Ztubben/autopilot_main_pcb/autopilot_main_board.kicad_pcb

## KiCad design autopilot_main_board.kicad_pcb (2026-03-28)

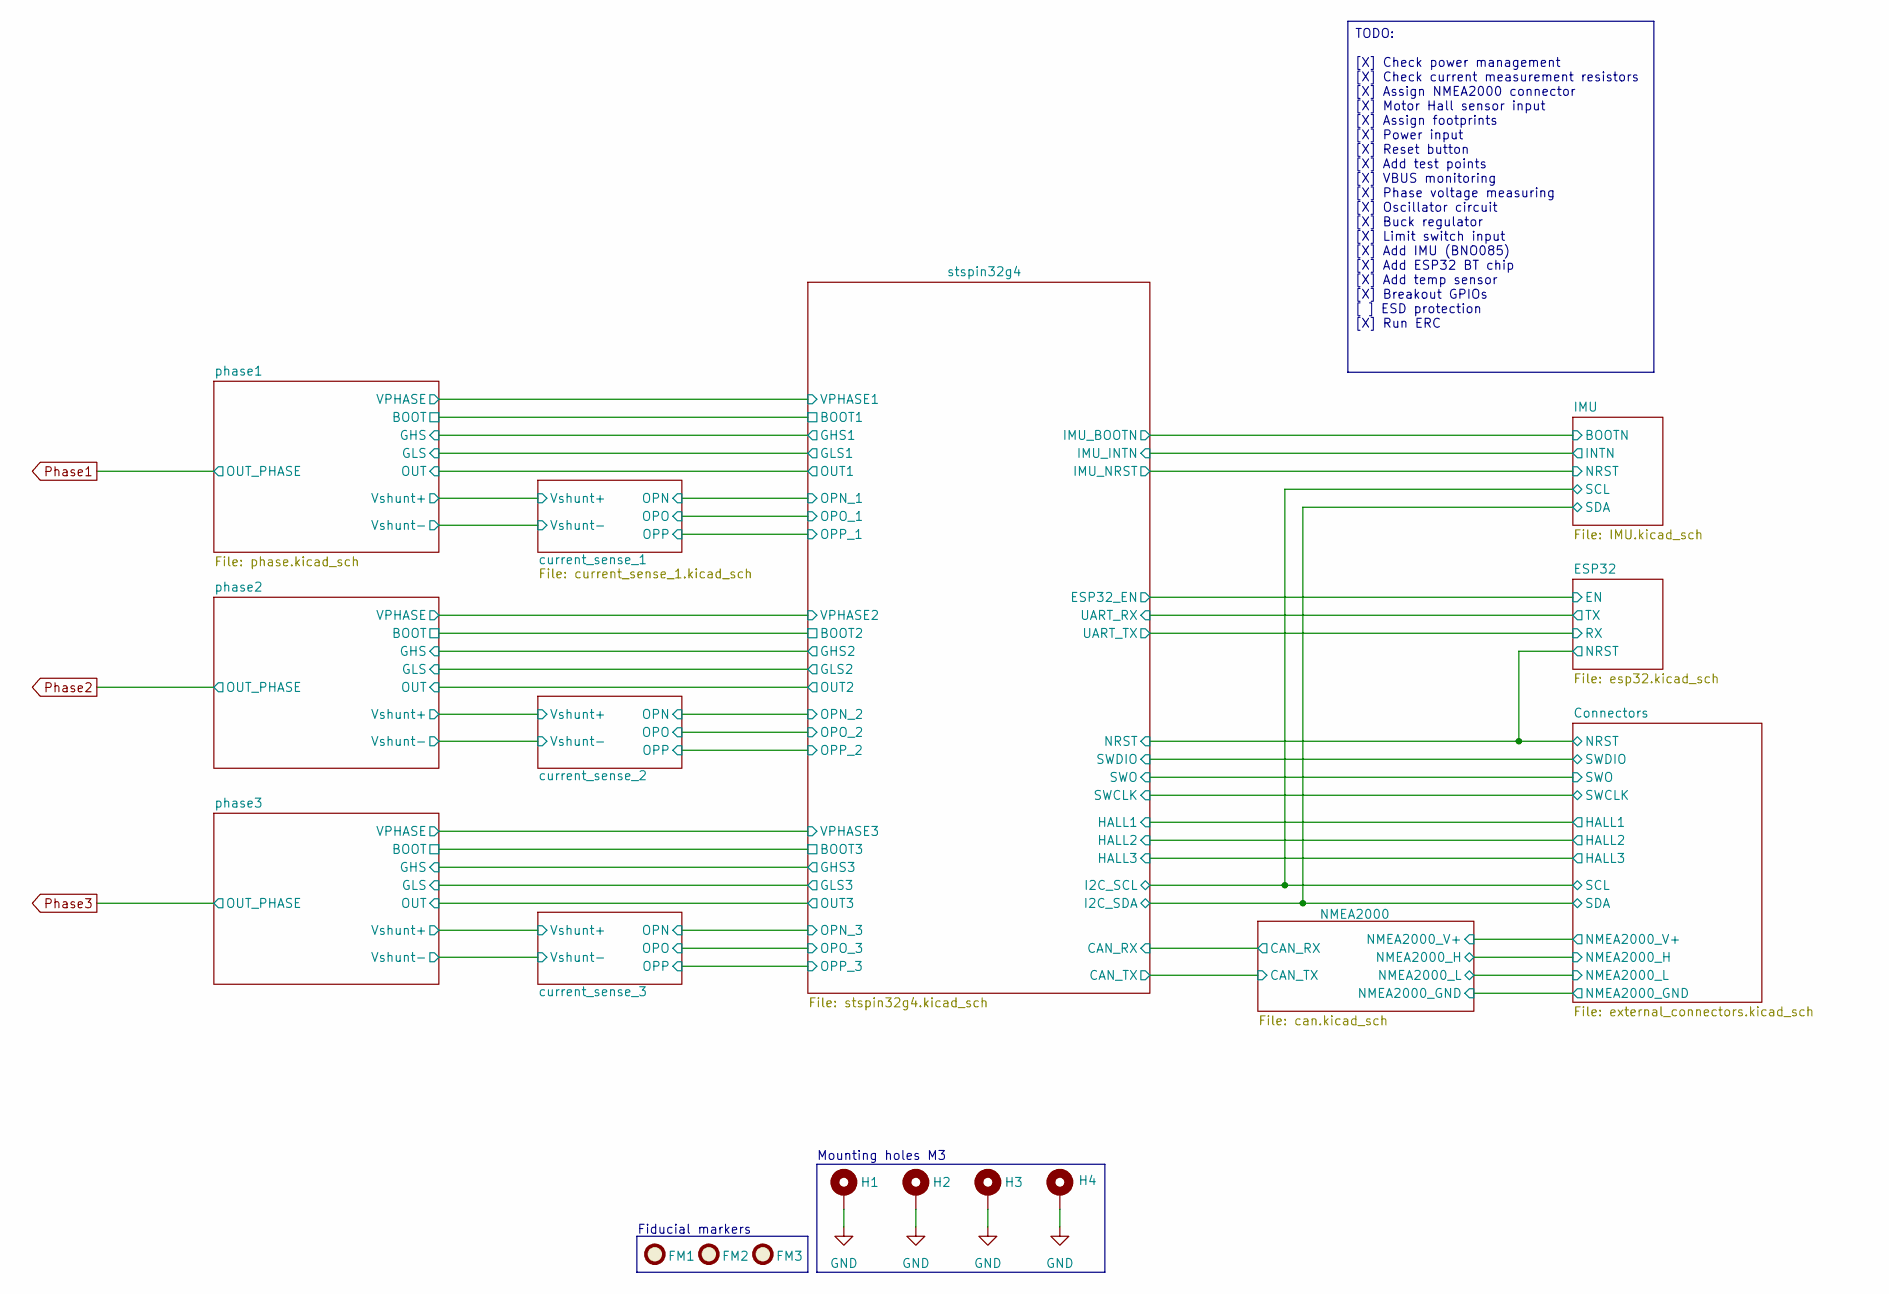
[picture p1: schematic autopilot_main_board.kicad_sch, Autopilot mainboard stspin32g4]

Parts:
FM1, FM2, FM3: Fiducial_1mm_Mask2mm
H1, H2, H3, H4: MountingHole_3.2mm_M3_DIN965_Pad

Connections:
GND: H1.1, H2.1, H3.1, H4.1; also elsewhere on the board

Notes on the sheet:
Mounting holes M3
Fiducial markers
TODO: [X] Check power management [X] Check current measurement resistors [X] Assign NMEA2000 connector [X] Motor Hall sensor input [X] Assign footprints [X] Power input [X] Reset button [X] Add test points [X] VBUS monitoring [X] Phase voltage measuring [X] Oscillator circuit [X] Buck regulator [X]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

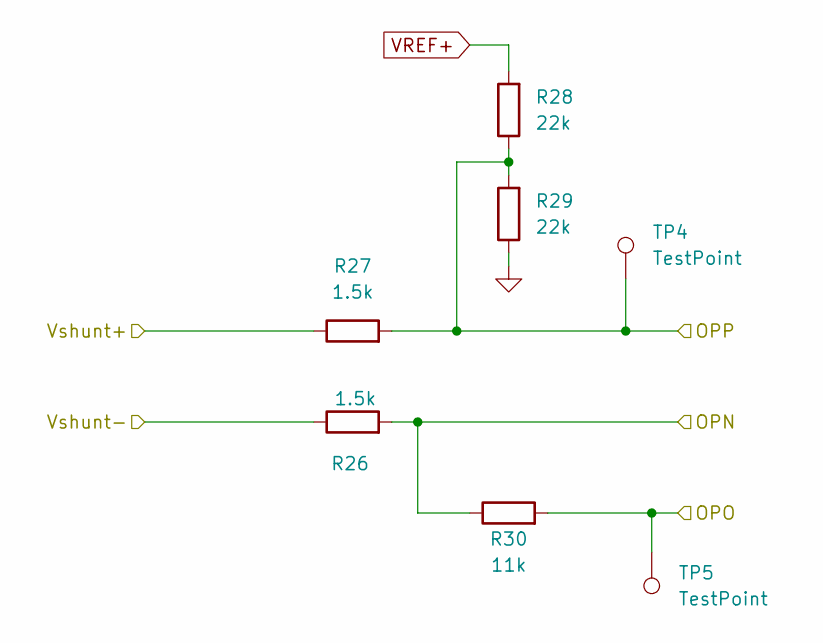
[picture p2: schematic current_sense_1.kicad_sch]

Parts:
R26, R27: 1.5k; R_0603_1608Metric
R28, R29: 22k; R_0603_1608Metric
R30: 11k; R_0603_1608Metric
TP4, TP5: TestPoint; TestPoint_Pad_D2.0mm

Connections:
/current_sense_1/OPN: R26.2, R30.1; also elsewhere on the board
/current_sense_1/OPO: R30.2, TP5.1; also elsewhere on the board
/current_sense_1/OPP: R27.2, R28.1, R29.2, TP4.1; also elsewhere on the board
/current_sense_1/Vshunt+: R27.1; also elsewhere on the board
GND: R26.1, R29.1; also elsewhere on the board
VREF+: R28.2; also elsewhere on the board

Parts of its further copies:
R31, R32, R44, R45: 1.5k; R_0603_1608Metric
R33, R34, R46, R47: 22k; R_0603_1608Metric
R35, R48: 11k; R_0603_1608Metric
TP6, TP7, TP8, TP9: TestPoint; TestPoint_Pad_D2.0mm

Connections of its further copies:
/current_sense_2/OPN: R31.2, R35.1; also elsewhere on the board
/current_sense_2/OPO: R35.2, TP7.1; also elsewhere on the board
/current_sense_2/OPP: R32.2, R33.1, R34.2, TP6.1; also elsewhere on the board
/current_sense_2/Vshunt+: R32.1; also elsewhere on the board
/current_sense_3/OPN: R44.2, R48.1; also elsewhere on the board
/current_sense_3/OPO: R48.2, TP9.1; also elsewhere on the board
/current_sense_3/OPP: R45.2, R46.1, R47.2, TP8.1; also elsewhere on the board
/current_sense_3/Vshunt+: R45.1; also elsewhere on the board
GND: R31.1, R34.1, R44.1, R47.1; also elsewhere on the board
VREF+: R33.2, R46.2; also elsewhere on the board

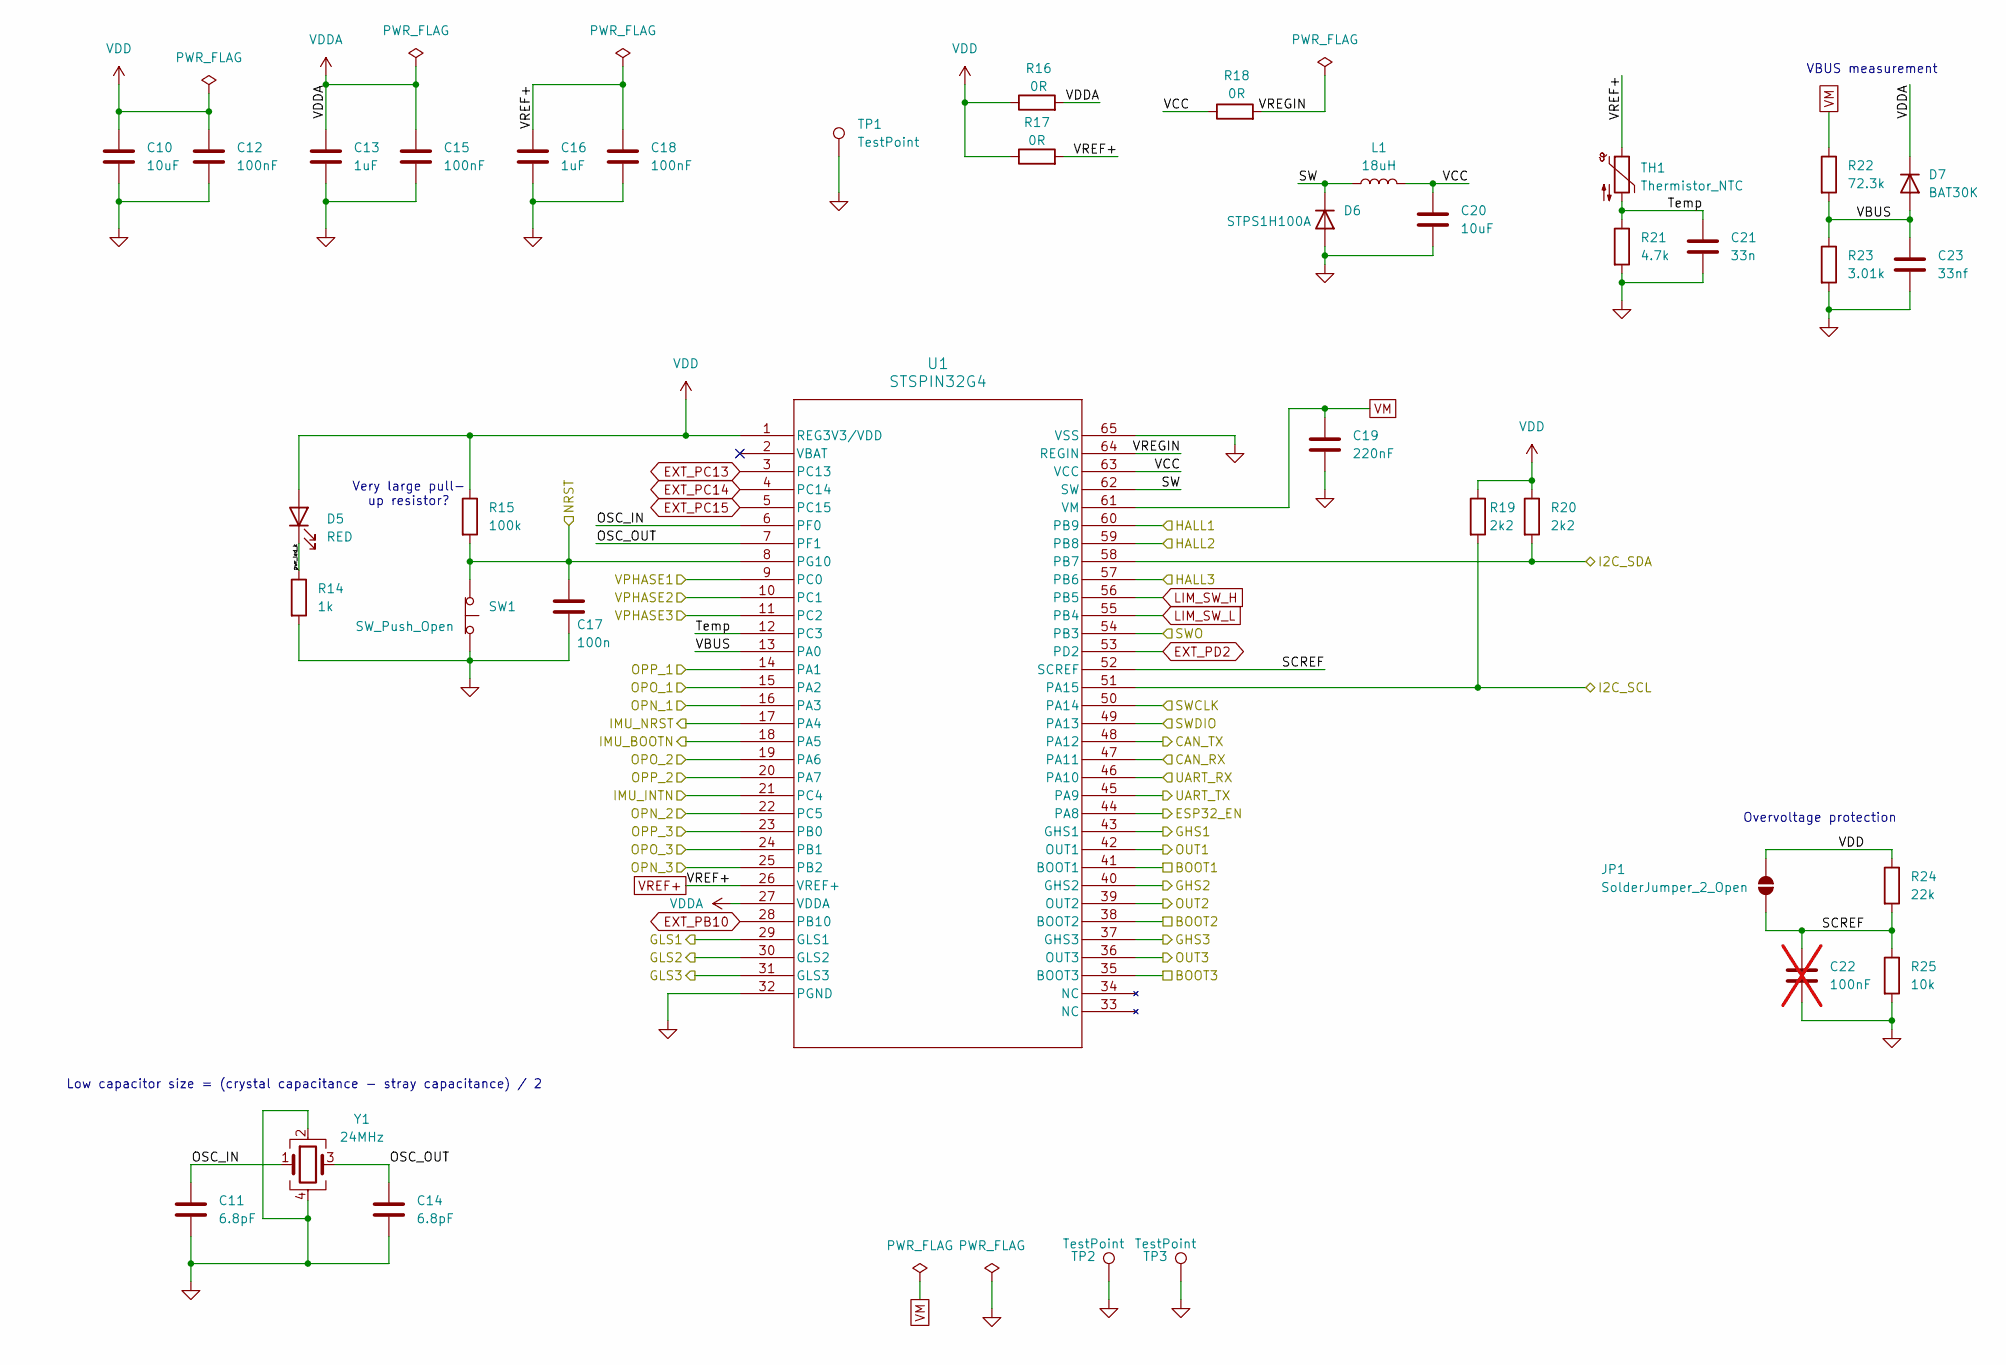
[picture p3: schematic stspin32g4.kicad_sch]

Parts:
C10, C20: 10uF; C_1206_3216Metric
C11, C14: 6.8pF; C_1206_3216Metric
C12, C15, C18: 100nF; C_1206_3216Metric
C13, C16: 1uF; C_1206_3216Metric
C17: 100n; C_1206_3216Metric
C19: 220nF; C_1206_3216Metric
C21: 33n; C_1206_3216Metric
C22: 100nF; C_1206_3216Metric; not fitted
C23: 33nf; C_1206_3216Metric
D5: RED; LED_1206_3216Metric
D6: STPS1H100A; D_1206_3216Metric
D7: BAT30K; D_1206_3216Metric
JP1: SolderJumper_2_Open; SolderJumper-2_P1.3mm_Open_RoundedPad1.0x1.5mm
L1: 18uH; L_1206_3216Metric
R14: 1k; R_0603_1608Metric
R15: 100k; R_0603_1608Metric
R16, R17, R18: 0R; R_0603_1608Metric
R19, R20: 2k2; R_0603_1608Metric
R21: 4.7k; R_0603_1608Metric
R22: 72.3k; R_0603_1608Metric
R23: 3.01k; R_0603_1608Metric
R24: 22k; R_0603_1608Metric
R25: 10k; R_0603_1608Metric
SW1: SW_Push_Open; SW_Tactile_Straight_KSA0Axx1LFTR
TH1: Thermistor_NTC; R_1206_3216Metric
TP1, TP2, TP3: TestPoint; TestPoint_Pad_D2.0mm
U1: STSPIN32G4; QFN-64_EP_9.85x9.85_Pitch0.5mm
Y1: 24MHz; Crystal_SMD_3225-4Pin_3.2x2.5mm

Connections:
/Connectors/HALL1: U1.60 (PB9); also elsewhere on the board
/Connectors/HALL2: U1.59 (PB8); also elsewhere on the board
/Connectors/HALL3: U1.57 (PB6); also elsewhere on the board
/Connectors/NRST: C17.1, R15.2, SW1.2 (B), U1.8 (PG10); also elsewhere on the board
/Connectors/SCL: R19.2, U1.51 (PA15); also elsewhere on the board
/Connectors/SDA: R20.2, U1.58 (PB7); also elsewhere on the board
/Connectors/SWCLK: U1.50 (PA14); also elsewhere on the board
/Connectors/SWDIO: U1.49 (PA13); also elsewhere on the board
/Connectors/SWO: U1.54 (PB3); also elsewhere on the board
/ESP32/EN: U1.44 (PA8); also elsewhere on the board
/ESP32/RX: U1.45 (PA9); also elsewhere on the board
/ESP32/TX: U1.46 (PA10); also elsewhere on the board
/IMU/BOOTN: U1.18 (PA5); also elsewhere on the board
/IMU/INTN: U1.21 (PC4); also elsewhere on the board
/IMU/NRST: U1.17 (PA4); also elsewhere on the board
/NMEA2000/CAN_RX: U1.47 (PA11); also elsewhere on the board
/NMEA2000/CAN_TX: U1.48 (PA12); also elsewhere on the board
/current_sense_1/OPN: U1.16 (PA3); also elsewhere on the board
/current_sense_1/OPO: U1.15 (PA2); also elsewhere on the board
/current_sense_1/OPP: U1.14 (PA1); also elsewhere on the board
/current_sense_2/OPN: U1.22 (PC5); also elsewhere on the board
/current_sense_2/OPO: U1.19 (PA6); also elsewhere on the board
/current_sense_2/OPP: U1.20 (PA7); also elsewhere on the board
/current_sense_3/OPN: U1.25 (PB2); also elsewhere on the board
/current_sense_3/OPO: U1.24 (PB1); also elsewhere on the board
/current_sense_3/OPP: U1.23 (PB0); also elsewhere on the board
/phase1/BOOT: U1.41 (BOOT1); also elsewhere on the board
/phase1/GHS: U1.43 (GHS1); also elsewhere on the board
/phase1/GLS: U1.29 (GLS1); also elsewhere on the board
/phase1/VPHASE: U1.9 (PC0); also elsewhere on the board
/phase2/BOOT: U1.38 (BOOT2); also elsewhere on the board
/phase2/GHS: U1.40 (GHS2); also elsewhere on the board
/phase2/GLS: U1.30 (GLS2); also elsewhere on the board
/phase2/VPHASE: U1.10 (PC1); also elsewhere on the board
/phase3/BOOT: U1.35 (BOOT3); also elsewhere on the board
/phase3/GHS: U1.37 (GHS3); also elsewhere on the board
/phase3/GLS: U1.31 (GLS3); also elsewhere on the board
/phase3/VPHASE: U1.11 (PC2); also elsewhere on the board
/stspin32g4/OSC_IN: C11.1, U1.6 (PF0), Y1.1
/stspin32g4/OSC_OUT: C14.1, U1.7 (PF1), Y1.3
/stspin32g4/SCREF: C22.1, JP1.1 (A), R24.2, R25.1, U1.52 (SCREF)
/stspin32g4/SW: D6.1 (K), L1.1, U1.62 (SW)
/stspin32g4/Temp: C21.1, R21.1, TH1.2, U1.12 (PC3)
/stspin32g4/VBUS: C23.1, D7.2 (A), R22.2, R23.1, U1.13 (PA0)
/stspin32g4/VCC: C20.1, L1.2, R18.1, U1.63 (VCC)
/stspin32g4/VREGIN: R18.2, U1.64 (REGIN)
/stspin32g4/pwr_led_k: D5.1 (K), R14.1
EXT_PB10: U1.28 (PB10); also elsewhere on the board
EXT_PC13: U1.3 (PC13); also elsewhere on the board
EXT_PC14: U1.4 (PC14); also elsewhere on the board
EXT_PC15: U1.5 (PC15); also elsewhere on the board
EXT_PD2: U1.53 (PD2); also elsewhere on the board
GND: C10.2, C11.2, C12.2, C13.2, C14.2, C15.2, C16.2, C17.2, C18.2, C19.2, C20.2, C21.2, C22.2, C23.2, D6.2 (A), R14.2, R21.2, R23.2, R25.2, SW1.1 (A), TP1.1, TP2.1, TP3.1, U1.32 (PGND), U1.65 (VSS), Y1.2, Y1.4; also elsewhere on the board
LIM_SW_H: U1.56 (PB5); also elsewhere on the board
LIM_SW_L: U1.55 (PB4); also elsewhere on the board
Phase1: U1.42 (OUT1); also elsewhere on the board
Phase2: U1.39 (OUT2); also elsewhere on the board
Phase3: U1.36 (OUT3); also elsewhere on the board
VDD: C10.1, C12.1, D5.2 (A), JP1.2 (B), R15.1, R16.1, R17.1, R19.1, R20.1, R24.1, U1.1 (REG3V3/VDD); also elsewhere on the board
VDDA: C13.1, C15.1, D7.1 (K), R16.2, U1.27 (VDDA); also elsewhere on the board
VM: C19.1, R22.1, U1.61 (VM); also elsewhere on the board
VREF+: C16.1, C18.1, R17.2, TH1.1, U1.26 (VREF+); also elsewhere on the board

Notes on the sheet:
Low capacitor size = (crystal capacitance - stray capacitance) / 2
VBUS measurement
Very large pull- up resistor?
Overvoltage protection

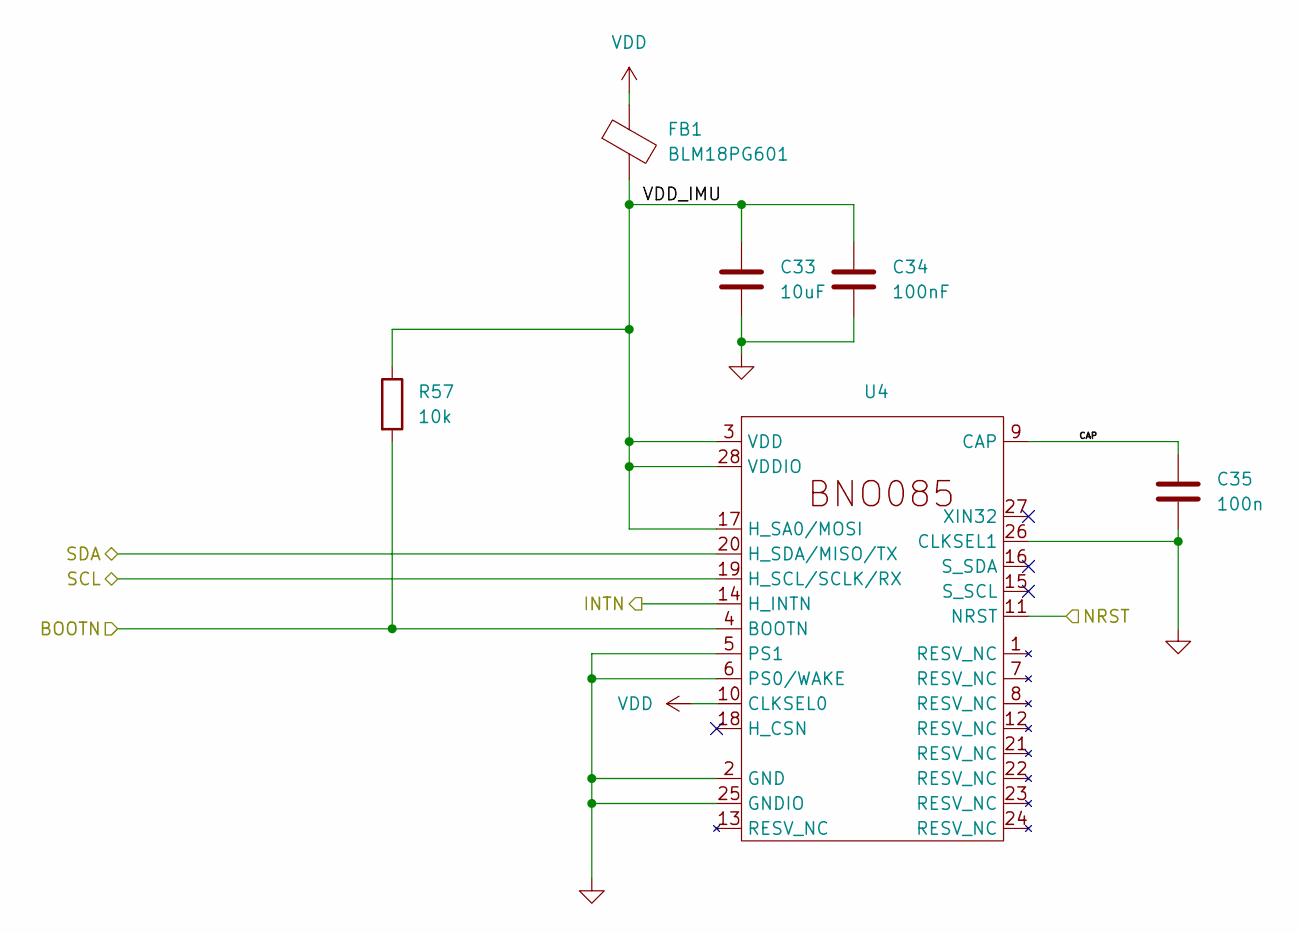
[picture p4: schematic IMU.kicad_sch]

Parts:
C33: 10uF; C_1206_3216Metric
C34: 100nF; C_1206_3216Metric
C35: 100n; C_1206_3216Metric
FB1: BLM18PG601; L_1206_3216Metric
R57: 10k; R_0603_1608Metric
U4: BNO085

Connections:
/Connectors/SCL: U4.19 (H_SCL/SCLK/RX); also elsewhere on the board
/Connectors/SDA: U4.20 (H_SDA/MISO/TX); also elsewhere on the board
/IMU/BOOTN: R57.2, U4.4 (BOOTN); also elsewhere on the board
/IMU/CAP: C35.1, U4.9 (CAP)
/IMU/INTN: U4.14 (H_INTN); also elsewhere on the board
/IMU/NRST: U4.11 (NRST); also elsewhere on the board
/IMU/VDD_IMU: C33.1, C34.1, FB1.2, R57.1, U4.3 (VDD), U4.17 (H_SA0/MOSI), U4.28 (VDDIO)
GND: C33.2, C34.2, C35.2, U4.2 (GND), U4.5 (PS1), U4.6 (PS0/WAKE), U4.25 (GNDIO), U4.26 (CLKSEL1); also elsewhere on the board
VDD: FB1.1, U4.10 (CLKSEL0); also elsewhere on the board

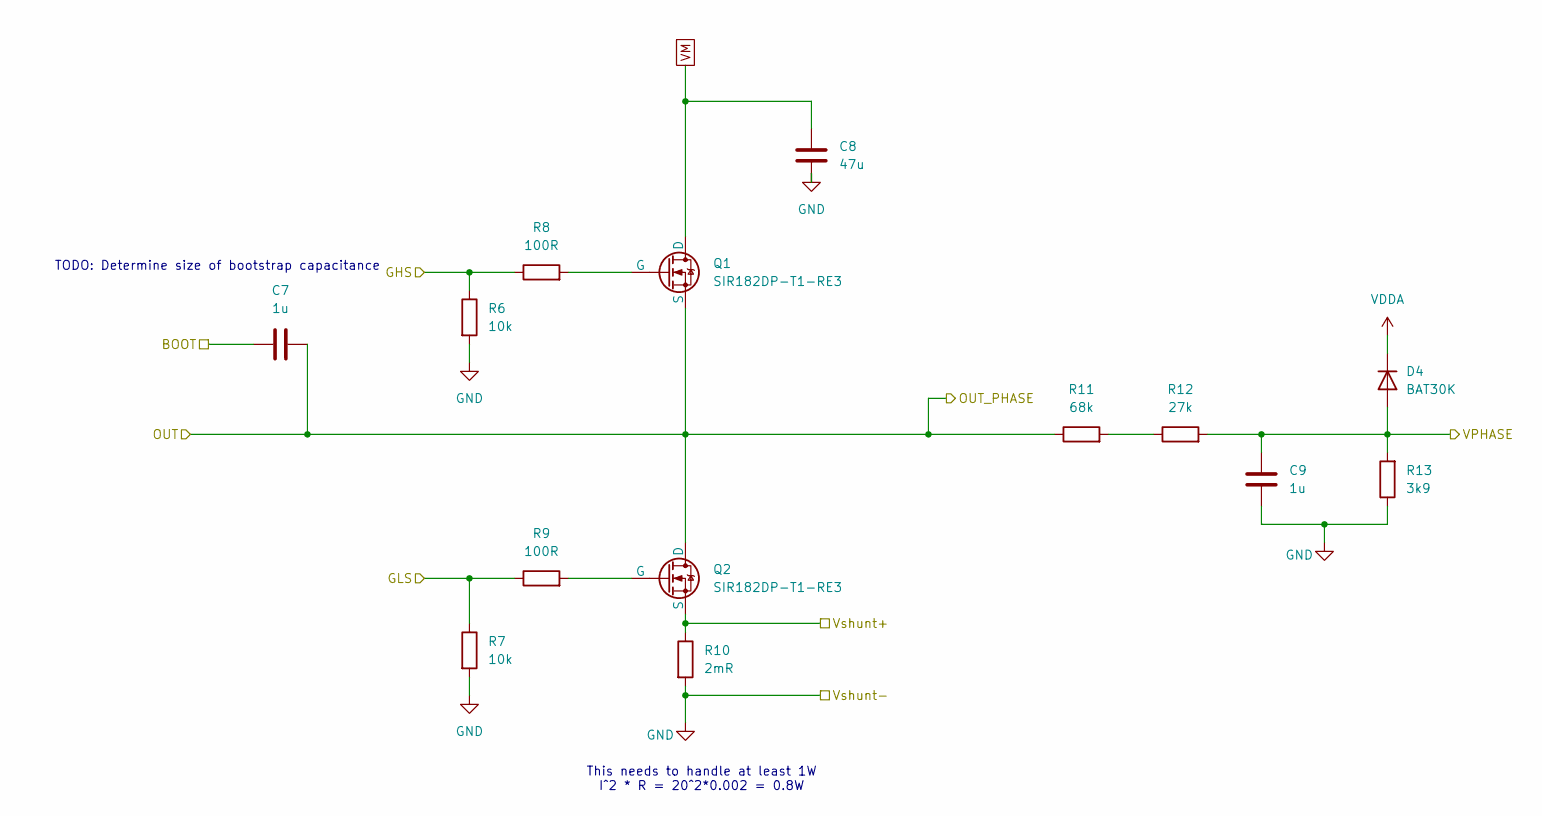
[picture p5: schematic phase.kicad_sch]

Parts:
C7, C9: 1u; C_1206_3216Metric
C8: 47u; C_1206_3216Metric
D4: BAT30K; D_1206_3216Metric
Q1, Q2: SIR182DP-T1-RE3; POWERPAK_SO-8_SINGLE_VIS
R6, R7: 10k; R_0603_1608Metric
R8, R9: 100R; R_0603_1608Metric
R10: 2mR; R_0603_1608Metric
R11: 68k; R_0603_1608Metric
R12: 27k; R_0603_1608Metric
R13: 3k9; R_0603_1608Metric

Connections:
/current_sense_1/Vshunt+: Q2.3 (S), R10.1; also elsewhere on the board
/phase1/BOOT: C7.2; also elsewhere on the board
/phase1/GHS: R6.1, R8.1; also elsewhere on the board
/phase1/GLS: R7.1, R9.1; also elsewhere on the board
/phase1/VPHASE: C9.2, D4.2 (A), R12.2, R13.2; also elsewhere on the board
GND: C8.2, C9.1, R6.2, R7.2, R10.2, R13.1; also elsewhere on the board
unnamed: Q1.2 (G), R8.2
unnamed: Q2.2 (G), R9.2
unnamed: R11.2, R12.1
Phase1: C7.1, Q1.3 (S), Q2.1 (D), R11.1; also elsewhere on the board
VDDA: D4.1 (K); also elsewhere on the board
VM: C8.1, Q1.1 (D); also elsewhere on the board

Parts of its further copies:
C26, C28, C29, C31: 1u; C_1206_3216Metric
C27, C30: 47u; C_1206_3216Metric
D8, D9: BAT30K; D_1206_3216Metric
Q3, Q4, Q5, Q6: SIR182DP-T1-RE3; POWERPAK_SO-8_SINGLE_VIS
R36, R37, R49, R50: 10k; R_0603_1608Metric
R38, R39, R51, R52: 100R; R_0603_1608Metric
R40, R53: 2mR; R_0603_1608Metric
R41, R54: 68k; R_0603_1608Metric
R42, R55: 27k; R_0603_1608Metric
R43, R56: 3k9; R_0603_1608Metric

Connections of its further copies:
/current_sense_2/Vshunt+: Q4.3 (S), R40.1; also elsewhere on the board
/current_sense_3/Vshunt+: Q6.3 (S), R53.1; also elsewhere on the board
/phase2/BOOT: C26.2; also elsewhere on the board
/phase2/GHS: R36.1, R38.1; also elsewhere on the board
/phase2/GLS: R37.1, R39.1; also elsewhere on the board
/phase2/VPHASE: C28.2, D8.2 (A), R42.2, R43.2; also elsewhere on the board
/phase3/BOOT: C29.2; also elsewhere on the board
/phase3/GHS: R49.1, R51.1; also elsewhere on the board
/phase3/GLS: R50.1, R52.1; also elsewhere on the board
/phase3/VPHASE: C31.2, D9.2 (A), R55.2, R56.2; also elsewhere on the board
GND: C27.2, C28.1, C30.2, C31.1, R36.2, R37.2, R40.2, R43.1, R49.2, R50.2, R53.2, R56.1; also elsewhere on the board
unnamed: Q3.2 (G), R38.2
unnamed: Q4.2 (G), R39.2
unnamed: Q5.2 (G), R51.2
unnamed: Q6.2 (G), R52.2
unnamed: R41.2, R42.1
unnamed: R54.2, R55.1
Phase2: C26.1, Q3.3 (S), Q4.1 (D), R41.1; also elsewhere on the board
Phase3: C29.1, Q5.3 (S), Q6.1 (D), R54.1; also elsewhere on the board
VDDA: D8.1 (K), D9.1 (K); also elsewhere on the board
VM: C27.1, C30.1, Q3.1 (D), Q5.1 (D); also elsewhere on the board

Notes on the sheet:
This needs to handle at least 1W I^2 * R = 20^2*0.002 = 0.8W
TODO: Determine size of bootstrap capacitance

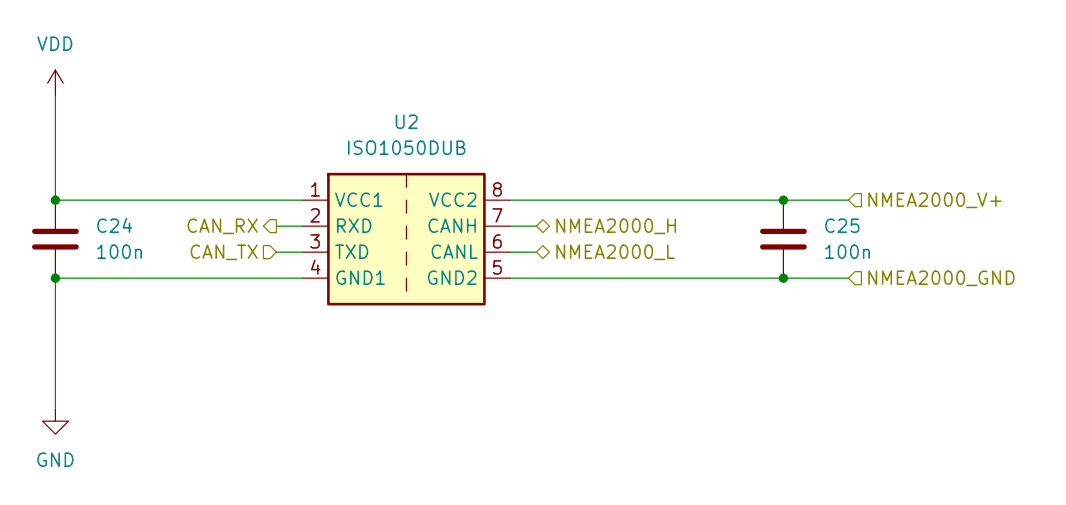
[picture p6: schematic can.kicad_sch]

Parts:
C24, C25: 100n; C_1206_3216Metric
U2: ISO1050DUB; SOP-8_6.62x9.15mm_P2.54mm

Connections:
/Connectors/NMEA2000_GND: C25.2, U2.5 (GND2); also elsewhere on the board
/Connectors/NMEA2000_H: U2.7 (CANH); also elsewhere on the board
/Connectors/NMEA2000_L: U2.6 (CANL); also elsewhere on the board
/Connectors/NMEA2000_V+: C25.1, U2.8 (VCC2); also elsewhere on the board
/NMEA2000/CAN_RX: U2.2 (RXD); also elsewhere on the board
/NMEA2000/CAN_TX: U2.3 (TXD); also elsewhere on the board
GND: C24.2, U2.4 (GND1); also elsewhere on the board
VDD: C24.1, U2.1 (VCC1); also elsewhere on the board

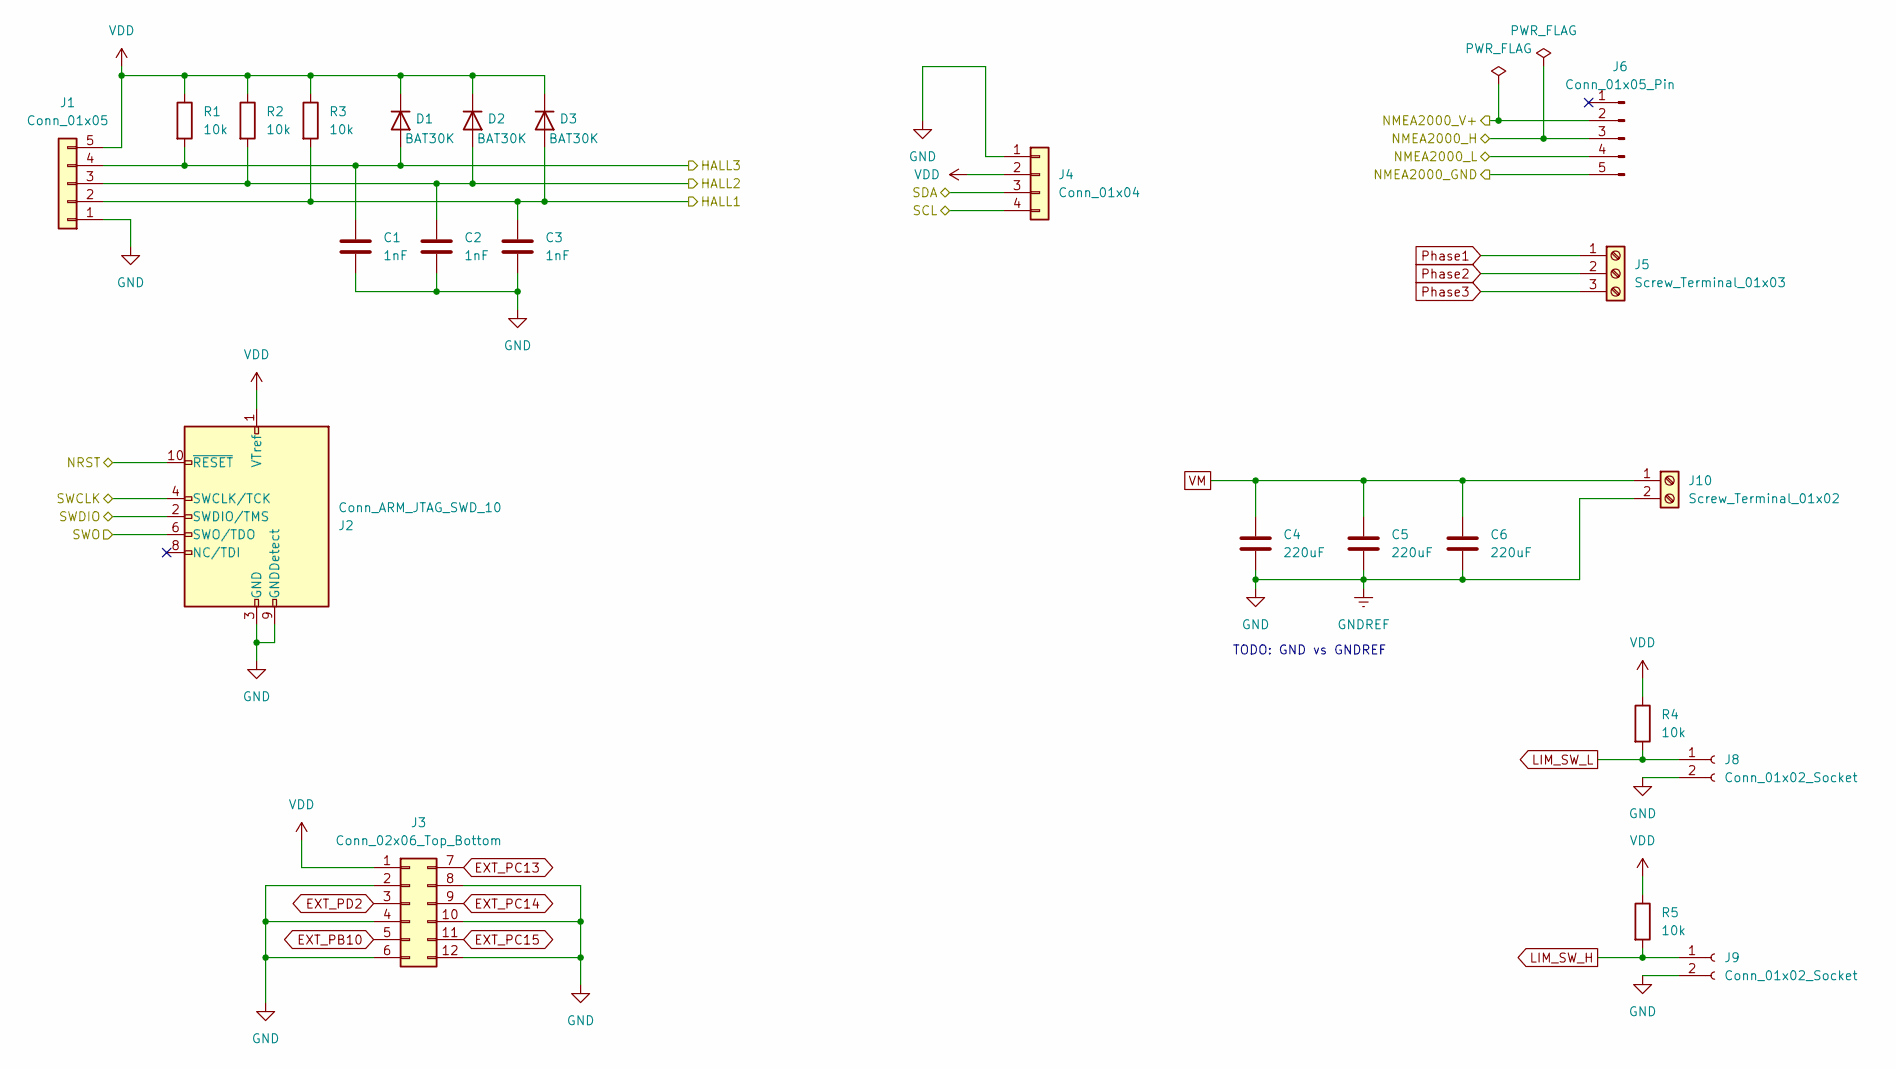
[picture p7: schematic external_connectors.kicad_sch, Inputs and Outputs]

Parts:
C1, C2, C3: 1nF; C_1206_3216Metric
C4, C5, C6: 220uF; C_1206_3216Metric
D1, D2, D3: BAT30K; D_1206_3216Metric
J1: Conn_01x05; JST_XH_B5B-XH-A_1x05_P2.50mm_Vertical
J2: Conn_ARM_JTAG_SWD_10; PinHeader_2x05_P1.27mm_Vertical_SMD
J3: Conn_02x06_Top_Bottom; PinHeader_2x06_P2.54mm_Vertical
J4: Conn_01x04; JST_XH_B4B-XH-A_1x04_P2.50mm_Vertical
J5: Screw_Terminal_01x03; TerminalBlock_MaiXu_MX126-5.0-03P_1x03_P5.00mm
J6: Conn_01x05_Pin; JST_XH_B5B-XH-AM_1x05_P2.50mm_Vertical
J8, J9: Conn_01x02_Socket; JST_XH_B2B-XH-AM_1x02_P2.50mm_Vertical
J10: Screw_Terminal_01x02; TerminalBlock_MaiXu_MX126-5.0-02P_1x02_P5.00mm
R1, R2, R3, R4, R5: 10k; R_0603_1608Metric

Connections:
/Connectors/HALL1: C3.1, D3.2 (A), J1.2, R3.2; also elsewhere on the board
/Connectors/HALL2: C2.1, D2.2 (A), J1.3, R2.2; also elsewhere on the board
/Connectors/HALL3: C1.1, D1.2 (A), J1.4, R1.2; also elsewhere on the board
/Connectors/NMEA2000_GND: J6.5; also elsewhere on the board
/Connectors/NMEA2000_H: J6.3; also elsewhere on the board
/Connectors/NMEA2000_L: J6.4; also elsewhere on the board
/Connectors/NMEA2000_V+: J6.2; also elsewhere on the board
/Connectors/NRST: J2.10 (~RESET); also elsewhere on the board
/Connectors/SCL: J4.4; also elsewhere on the board
/Connectors/SDA: J4.3; also elsewhere on the board
/Connectors/SWCLK: J2.4 (SWCLK/TCK); also elsewhere on the board
/Connectors/SWDIO: J2.2 (SWDIO/TMS); also elsewhere on the board
/Connectors/SWO: J2.6 (SWO/TDO); also elsewhere on the board
EXT_PB10: J3.5; also elsewhere on the board
EXT_PC13: J3.7; also elsewhere on the board
EXT_PC14: J3.9; also elsewhere on the board
EXT_PC15: J3.11; also elsewhere on the board
EXT_PD2: J3.3; also elsewhere on the board
GND: C1.2, C2.2, C3.2, C4.2, C5.2, C6.2, J1.1, J2.3 (GND), J2.5 (GND), J2.9 (GNDDetect), J3.2, J3.4, J3.6, J3.8, J3.10, J3.12, J4.1, J8.2, J9.2, J10.2; also elsewhere on the board
LIM_SW_H: J9.1, R5.2; also elsewhere on the board
LIM_SW_L: J8.1, R4.2; also elsewhere on the board
Phase1: J5.1; also elsewhere on the board
Phase2: J5.2; also elsewhere on the board
Phase3: J5.3; also elsewhere on the board
VDD: D1.1 (K), D2.1 (K), D3.1 (K), J1.5, J2.1 (VTref), J3.1, J4.2, R1.1, R2.1, R3.1, R4.1, R5.1; also elsewhere on the board
VM: C4.1, C5.1, C6.1, J10.1; also elsewhere on the board

Notes on the sheet:
TODO: GND vs GNDREF

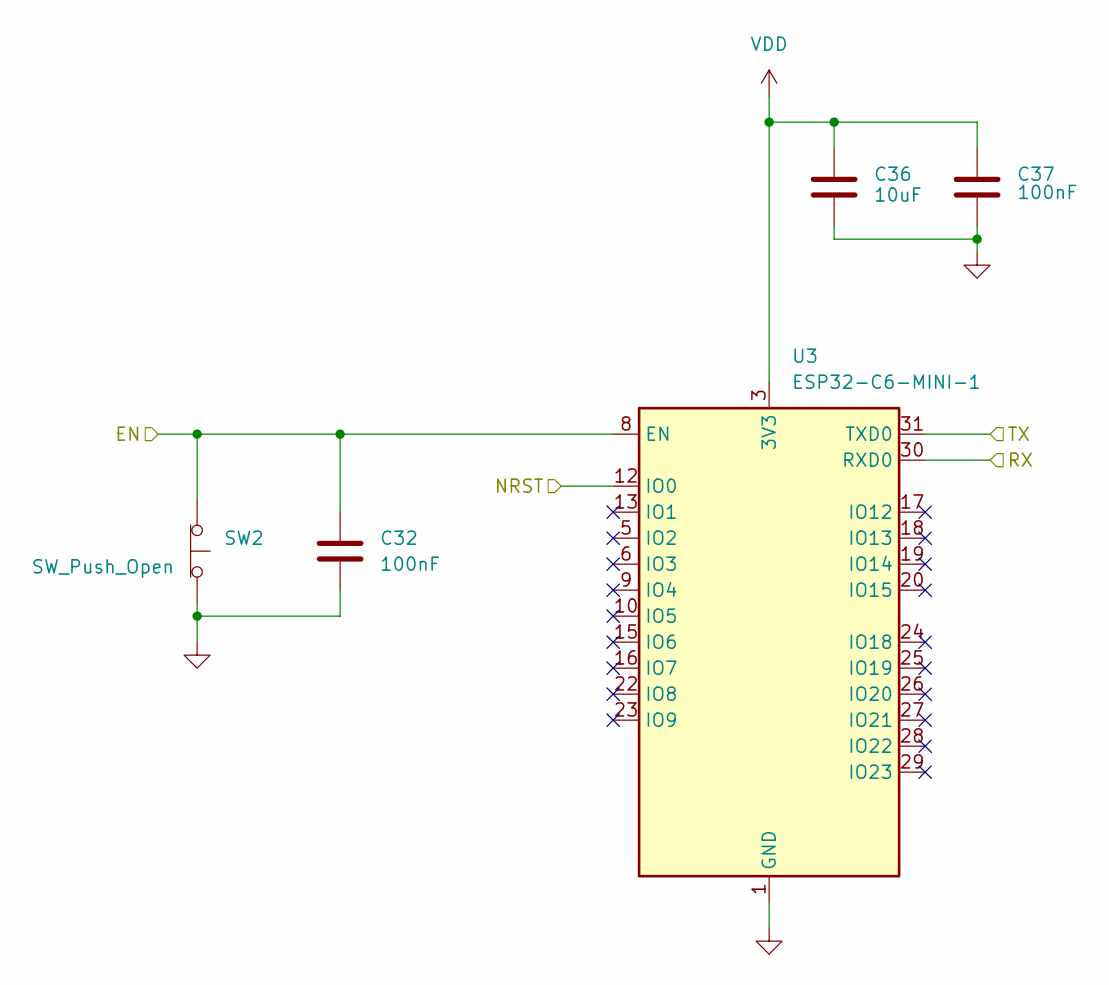
[picture p8: schematic esp32.kicad_sch]

Parts:
C32, C37: 100nF; C_1206_3216Metric
C36: 10uF; C_1206_3216Metric
SW2: SW_Push_Open; SW_Tactile_Straight_KSA0Axx1LFTR
U3: ESP32-C6-MINI-1

Connections:
/Connectors/NRST: U3.12 (IO0); also elsewhere on the board
/ESP32/EN: C32.1, SW2.2 (B), U3.8 (EN); also elsewhere on the board
/ESP32/RX: U3.30 (RXD0); also elsewhere on the board
/ESP32/TX: U3.31 (TXD0); also elsewhere on the board
GND: C32.2, C36.2, C37.2, SW2.1 (A), U3.1 (GND), U3.2 (GND), U3.11 (GND), U3.14 (GND), U3.36 (GND), U3.37 (GND), U3.38 (GND), U3.39 (GND), U3.40 (GND), U3.41 (GND), U3.42 (GND), U3.43 (GND), U3.44 (GND), U3.45 (GND), U3.46 (GND), U3.47 (GND), U3.48 (GND), U3.49 (GND), U3.50 (GND), U3.51 (GND), U3.52 (GND), U3.53 (GND); also elsewhere on the board
VDD: C36.1, C37.1, U3.3 (3V3); also elsewhere on the board

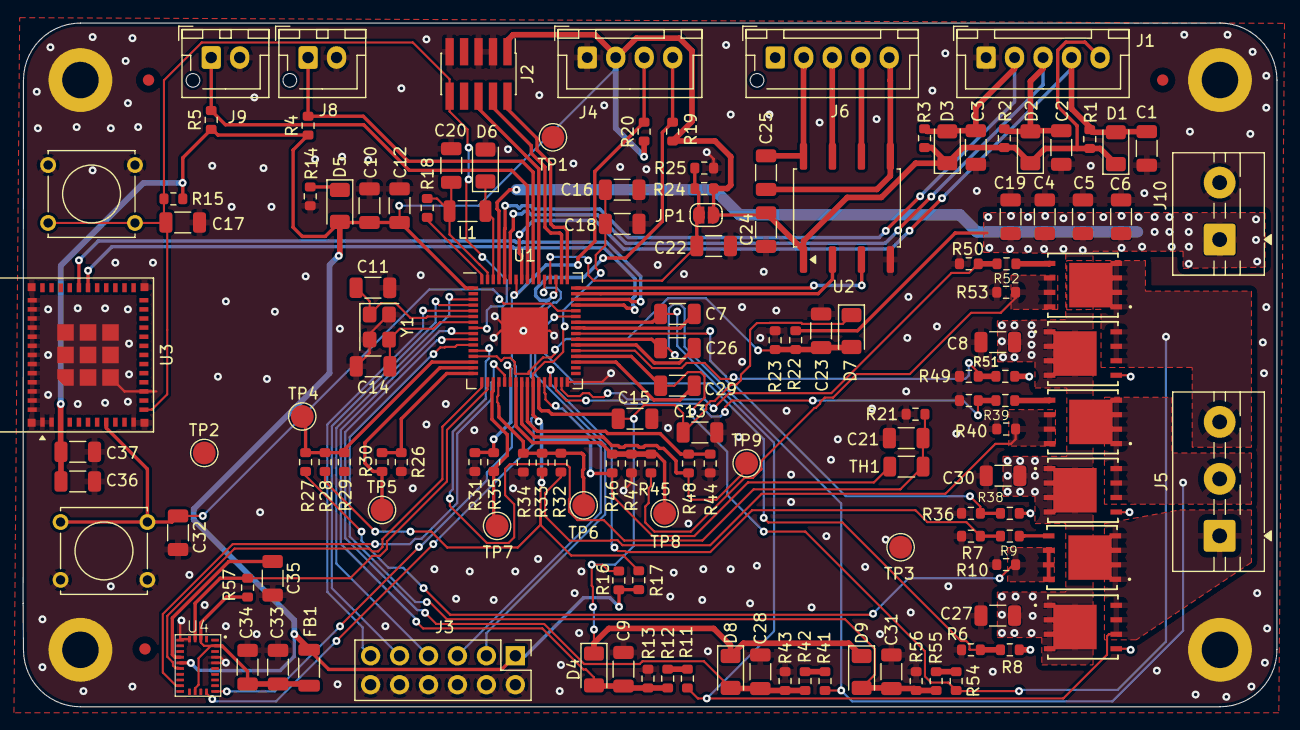
[picture p9: board autopilot_main_board.kicad_pcb from above]

Board: 4 copper layers, 110.0 x 60.0 mm, 145 parts (0 on the bottom side), 80 nets.
