Ztubben/autopilot_main_pcb/(commit log)

2026-03-14 Add kicad project
    [IMU.kicad_sch, autopilot_main_board.kicad_pcb, autopilot_main_board.kicad_sch, can.kicad_sch, current_sense_1.kicad_sch, esp32.kicad_sch, external_connectors.kicad_sch, phase.kicad_sch]
2026-03-17 Remove unused files
    [IMU.kicad_sch, autopilot_main_board.kicad_sch, phase1.kicad_sch, phase_connector.kicad_sch]
2026-03-22 Initial PCB layout
    [IMU.kicad_sch, autopilot_main_board.kicad_pcb, autopilot_main_board.kicad_sch, current_sense_1.kicad_sch, esp32.kicad_sch, external_connectors.kicad_sch, stspin32g4.kicad_sch]
2026-03-24 Continued routing
    [IMU.kicad_sch, autopilot_main_board.kicad_pcb, esp32.kicad_sch]
2026-03-26 Routing complete
    [autopilot_main_board.kicad_pcb]
2026-03-28 DRC check completed
    [autopilot_main_board.kicad_pcb]
